SolarInvert-GmbH/inverter_assemblies--control_board/Stückliste_ST25.004_CT349066.xls

Bestück-Pos. | Menge | Artikel-Name | Artikel-Werte | Bauform | Toleranz | Hersteller | Artikel-Bezeichnung | Änd-index | Bemerkungen
Leiterplatte | 1 | Leiterplatte unbestückt | UL94-V0 120x65mm, FR4 1,55mm, 35µ Cu, Doppelseitig, Lötstopplack Top + Bottom grün, Positionsdruck top, weiß, HAL bleifrei, Ausfräsungen ca. 25mm |  |  |  | ST25.004.brd | 000
IC13 | 1 | Spannungsreferenz | 5,0V 100ppm 0,2% | SOT23-3 | 0,2 % | Fairchild | LM4040BIM3-5.0/NOPB | 003 | Farnell: 1468838
IC15 | 1 | Mikrocontroller |  | TQFP44 |  | Atmel | ATMEGA644PA-AU | 000 | Farnell: 1972106
IC12 | 1 | PMIC - Überwachungen |  | SOT23 |  | ON Semi / Catalyst | MAX809TTRG | 000 | Farnell: 1652405 Digikey: MAX809TTRGOSCT-ND
IC208 | 1 | HCF40106M013TR HCF40106BM1 | Hex Schmitt-Trigger | SOIC14 |  | ST Microelectronics ST Microelectronics | HCF40106M013TR HCF40106BM1 | 017 | Farnell: 1201301 Andere Hersteller sind gesperrt!
IC3, IC4, IC5, IC6, IC210 | 5 | CD4066BCMX HCF4066BM1 HEF4066BT | 4 Analogschalter | SOIC14 |  | Fairchild ST Microelectronics NXP | HEF4066BT | 019 | Digikey: 568-2266-1-ND Hersteller spezifiziert
IC209 | 1 | HCF4093M HEF4093 CD4093BCM HCF4093BM1 | 4 Schmitt-Trigger NAND | SOIC14 |  | ST Microelectronics NXP Fairchild ST Microelectronics | HEF4093BT | 017 | Farnell: 1201296 Hersteller spezifiziert
IC14 | 1 | RS-485 Transceiver IC | 3V to 5.5V | SOIC20W |  | Analog Devices | ADM2587EBRWZ | 000 | Digikey: ADM2587EBRWZ-REEL7TR-ND
IC201 | 1 | Operationsverstärker | 4fach | SOIC14 |  |  | LM248D | 000 | Farnell:
IC202 | 1 | Komparator | 4fach | SOIC14 |  |  | LM2901 | 000 | Digikey: 296-14593-1-ND
IC211 | 1 | D/A-Wandler |  | SOIC16 |  |  | MX7524LCSE | 000 | Digikey: MX7524LCSE+-ND
IC207 | 1 | Operationsverstärker | einfach | SO16DW |  |  | OP-200GS | 000
IC1, IC2 | 2 | I/O EXPANDER |  | TSSOP-16 |  | NXP | PCA8574PW,118 | 028 | schnellere Variante PCA... Digikey: 568-8700; Mouser No: 771-PCA85TS112 Farnell: 2212107
IC16 | 1 | Operationsverstärker | LM258 | SOIC-8 |  |  | LM258 | 027 | getestet LM258, alternative eventuell LM2904
IC17 | 1 | Optokoppler | FODM217D | SOP-4, MFP4 2.5x4.4, 1.27P |  |  | FODM217D
T201 | 1 | MOSFET | BSS123 | SOT23 | e | frei | BSS123 | 016 | Farnell: 9845321
D202, D211, D207, D203 | 4 | Doppeldiode | BAV99 | SOT23 |  | frei | BAV99LT1G | 006 | D11 --> D202 Farnell: 1431118
D205 | 1 | Doppeldiode | BAV70 | SOT23 |  | frei | BAV70 | 000 | Farnell: 1081208
D2, D10, D13, D209, D210, D213, D214, D215, D216, D217, | 10 | Diode SMD | LL1148 | SOD80C |  | frei | LL4148 | 0017 | D10,D13 hinzu Farnell: 1469399
D3, D1 | 2 | Diode | BAT46 | SOD80C |  |  | BAT46 | 020
LED1 | 1 | LED rot |  | PLCC-2 |  | Vishay | VLMS30J1L2-GS08 | 000 | Farnell: 1328348
LED2 | 1 | LED grün |  | PLCC-2 |  | Vishay | VLMC3100-GS08 | 000 | Farnell: 1659076
Q1 | 1 | Quarz | CRYSTAL 20MHZ 12PF SMD | 3,20 mm x 2,50 mm SMD |  | AKER | C3E-20.000-12-3030-X | 013 | Farnell: 1538859
T203, T204, T205, T206, T207 | 5 | 2-fach Transistor |  | SOT363-6 |  |  | MMDT5401-7-F | 017 | neu Farnell: 1773647
L1, L2 | 2 | DROSSEL | FERRITE CHIP BEAD 1k5@100MHz,300mA | 0603 oder 0805 |  | TDK |  | 005 | Digi-Key 445-2178-1-ND Farnell: 1635738
C8, C28 | 0 | SMD-Keramik-Kondensator | n.b. | 0805 | 5% | frei
C9, C10, C55, C245, C246 | 5 | SMD-Keramik-Kondensator | 12pF 5% | 0805 | 5% | frei |  | 005, 026 | Farnell: 1740650
C42, C53, C59, C216, C221, C220 | 6 | SMD-Keramik-Kondensator | 10µF/16V | 0805 | 20% | frei |  | 017 | C42 hinzu Farnell: 2320856
C2, C3, C4, C5, C26, C27, C29, C17 C18, C19, C20, C22, C23, C24, C37, C39, C41, C49, C54, C57, C58, C60, C61, C63, C64, C206, C215, C232, C234, C235, C236, C237, C238, C239, C240, C241, C242, C243, C247 | 39 | SMD-Keramik-Kondensator | 100nF/50V | 0805 | 20% | frei |  | 024 | Farnell: Entfall C42,
C7, C224, C225, C226, C227 | 5 | SMD-Keramik-Kondensator | 100pF/50V | 0805 | 20% | frei |  | 017 | Stückzahl korrigiert Farnell: 2210931
C1, C207, C244, C52, | 4 | SMD-Keramik-Kondensator | 10nF/50V | 0805 | 20% | frei |  | 020 | hinzu
C204 | 1 | SMD-Keramik-Kondensator | 4n7/50V | 0805 | 20% | frei |  | 029 | von 1nF auf 4n7:DC-Messung ruhiger
C16, C36, C205, C219, C223, | 5 | SMD-Keramik-Kondensator | 1nF/50V | 0805 | 10% | frei |  | 024 | Geändert auf 10% wegen C223 macht Takt!
C218 | 1 | SMD-Keramik-Kondensator | 1µF/25V | 0805 | 20% | frei |  | 016
 |  |  | Alle diese C´s reicht >=10V |  |  |  |  |  | Summenwert der Paare bei parallel löten
C250 | 1 | Keramikkondensator | 4n7 | 0805 | 5% | frei |  | 029 | 4n7 - 5n6 | eher oberes Fenster | Stufen bisher eher zu schwach
C250-2 | 1 | Keramikkondensator | 1nF | 0805 | 5% | frei |  | 029
C251 | 1 | Keramikkondensator | 5n6 | 0805 | 5% | frei |  | 029 | 10n - 11n
C251-2 | 1 | Keramikkondensator | 4n7 | 0805 | 5% | frei |  | 029
C252 | 1 | Keramikkondensator | 10nF | 0805 | 5% | frei |  | 029 | 20n - 22n
C252-2 | 1 | Keramikkondensator | 10nF | 0805 | 5% | frei |  | 029
C253 | 1 | Keramikkondensator | 22nF | 0805 | 5% | frei |  | 029 | 38n - 40n
C253-2 | 1 | Keramikkondensator | 18nF | 0805 | 5% | frei |  | 029
C254 | 1 | Keramikkondensator | 6n8 | 0805 | 5% | frei |  | 029 | 6n8 - 7n
C260 | 1 | Keramikkondensator | 3n3 | 0805 | 5% | frei |  | 029 | 3n9 - 4n3 | eher unteres Fenster | Steufen bisher eher zu stark
C260-2 | 1 | Keramikkondensator | 1nF | 0805 | 5% | frei |  | 029
C261 | 1 | Keramikkondensator | 4n7 | 0805 | 5% | frei |  | 029 | 8n - 8n2
C261-2 | 1 | Keramikkondensator | 3n3 | 0805 | 5% | frei |  | 029
C262 | 1 | Keramikkondensator | 8n2 | 0805 | 5% | frei |  | 029 | 15n - 16n
C262-2 | 1 | Keramikkondensator | 5n6 | 0805 | 5% | frei |  | 029
C263 | 1 | Keramikkondensator | 15nF | 0805 | 5% | frei |  | 029 | 28n - 30n
C263-2 | 1 | Keramikkondensator | 12nF | 0805 | 5% | frei |  | 029
C264 | 1 | Keramikkondensator | 6n8 | 0805 | 5% | frei |  | 029 | 6n8 - 7n
R30, R31, R32, R268 | 4 | SMD-Widerstand | 0R | 0805 | 10% | frei |  | 013
R269 | 1 | SMD-Widerstand | 120R | 0805 | 10% | frei |  | 026 | R27=n.b.
R240, R229, R233, R232, R221, R206, R205, R204,R209, R226, R223, R266, R278 | 13 | SMD-Widerstand | 100k | 0805 | 1% | frei |  | 013, 026, 029 | R266 zurück auf 100k, R209 von 47k zurück auf 100k (Overvoltage INT)
R201 | 1 | SMD-Widerstand | 100k | 0805 | 0,1% | frei |  | 013
R202 | 1 | SMD-Widerstand | 10k | 0805 | 0,1% | frei |  | 013
R203, R207, R228, R39, R239,R247, R248, R249, R253, R254, R255, R260, R277 | 13 | SMD-Widerstand | 10k | 0805 | 1% | frei |  | 019, 029 | R238, R239: 15k; R260 von 22k auf 10k Ar; R39, R239 dazu
R261 | 1 | SMD-Widerstand | 33k | 0805 | 1% | frei |  | 019 | R261 von 27k auf 33k Ar
R215, R222 | 2 | SMD-Widerstand | 68k | 0805 | 1% | frei |  | 019 | R215 von 75k auf 68k Ar
R244 | 1 | NTC | 10k NTC | 0805 |  |  |  | 015 | Farnell: 2103177
R238 | 1 | SMD-Widerstand | 15k | 0805 | 1% | frei |  | 026, 029 | R39, R239 nach 10k
R231,R208 | 2 | SMD-Widerstand | 10M | 0805 | 1% | frei |  | 000
R227 | 1 | SMD-Widerstand | 160k | 0805 | 1% | frei |  | 026, 029 | R266 zurück auf 100k,
R234, R235, R236, R237, R279 | 5 | SMD-Widerstand | 18k | 0805 | 1% | frei |  | 000, 029 | R279 hinzu von 5k6 (Overcurrent)
R22, R24, R28, R23, R246, R276 | 6 | SMD-Widerstand | 1k | 0805 | 1% | frei |  | 026
R216, R219, R243 | 3 | SMD-Widerstand | 1M | 0805 | 1% | frei |  | 019 | R218 von 2M auf 1M Ar
R218 | 1 | SMD-Widerstand | 390k | 0805 | 1% | frei |  | 021 | R218 von 1M auf 390k Ar
R29, R217 | 2 | SMD-Widerstand | 2M | 0805 | 1% | frei |  | 019 | R217 von 4M7 auf 2M Ar
R241, R242, R210 | 3 | SMD-Widerstand | 3k3 | 0805 | 1% | frei |  | 000, 029 | R220 nach 8k2
R1, R2, R3, R4, R5, R6, R7, R8, R9, R10, R11, R12, R13, R14, R15, R16, R17, R18, R19, R20, R211, R225, R230, R250 | 24 | SMD-Widerstand | 47k | 0805 | 1% | frei |  | 000, 029 | R209 nach 100k
R256, R257, R258, R259, R262, R263, | 6 | SMD-Widerstand | 4k7 | 0805 | 1% | frei |  | 017 | Farnell: 1099812, 9333274, R1...R20 neu, R220hinzu
R220,R252 | 1 | SMD-Widerstand | 8k2 | 0805 | 1% | frei |  | 013, 029 | R279 nach 18k, R252 von 5k6 auf 8k2 (Overcurrent Schwelle: einmal 5k6=8k2||18k einmal 8k2
R224, R267, R251 | 3 | SMD-Widerstand | 510k | 0805 | 1% | frei |  | 017 | 680k --> 510k
R270, R271 | 2 | SMD-Widerstand | 1k2 | 0805 | 1% | frei |  | 026, 029 | von 1k5 auf 1k2 RS485
R26, R25, R27, R33, R34, R38 | 0 | freies Pad | n.b. | 0805 |  |  |  | 026
R21, R35 | 2 | SMD-Widerstand | n.b. | 0805 | 1% | frei |  | 028, 029 | war 300k
R36, R37 | 0 | freies Pad | n.b. | 1812 |  |  |  | 028
PJ1 | 0 | Stiftleiste unbest. Abkleben | 22pol. 90°, vergoldet |  |  |  |  | 016 | Bürklin: 59F680 auf Bottom bestücken
PJ2 | 0 | Stiftleiste unbest. Abkleben | 6pol. |  |  |  |  | 016 | abkleben !!
JP1 | 1 | Stiftleiste | 2pol., RM2,54, 180° |  |  |  |  | 000 | Farnell: 3417645
JP1 | 0 | entfällt | rot, RM2,54 |  |  |  |  | 025 | Reichelt: jumper 2,54 RT Bürklin: 40 F 4236 nur innen stecken
J1 | 0 | PinSocket 2x5 1.27mm | n.b.
J3, J6 | 0 | freies THT Lötauge | n.b. | RM1,27 Pfostenstecker | 5Volt von NA Thema |  |  |  | abkleben !!
J2, J7 | 0 | freies THT Lötauge | n.b. | RM2.54Pfostenstecker | 5Volt von NA Thema |  |  | 028 | abkleben !!
J4, J5 | 2 | RJ45 Buchse | RJHSE-5380 | Raste oben |  |  | alternativ 603000-79 oder 603000-11 | 028
