SolarInvert-GmbH/inverter_assemblies--control_board/Bestückungsplan/ST25.004 Bestückungsplan BOT.pdf

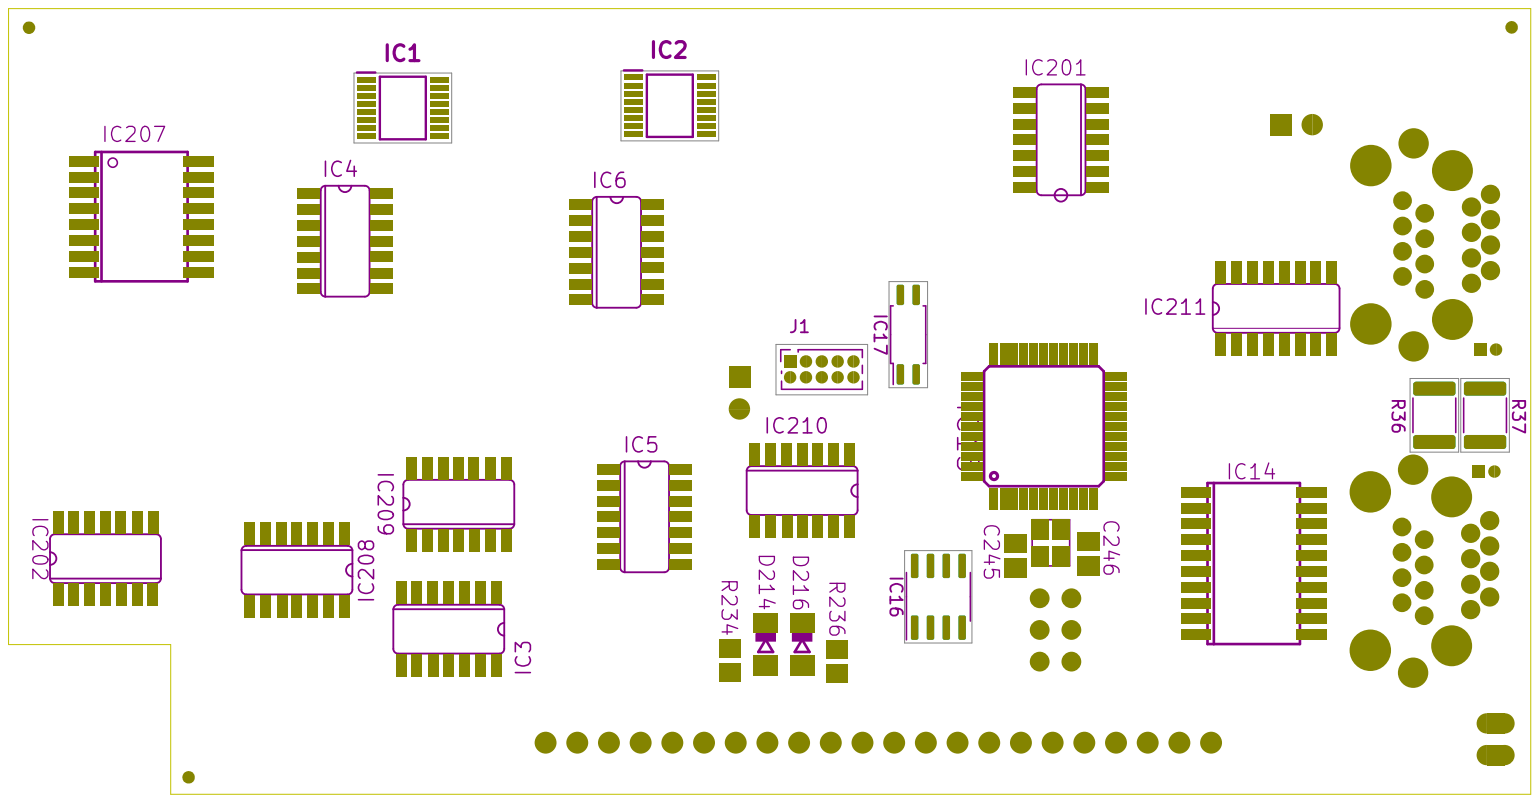
[picture p1: page 1]
