SolarInvert-GmbH/inverter_assemblies--control_board/Bestückungsplan/ST25.004 Bestückungsplan TOP.pdf

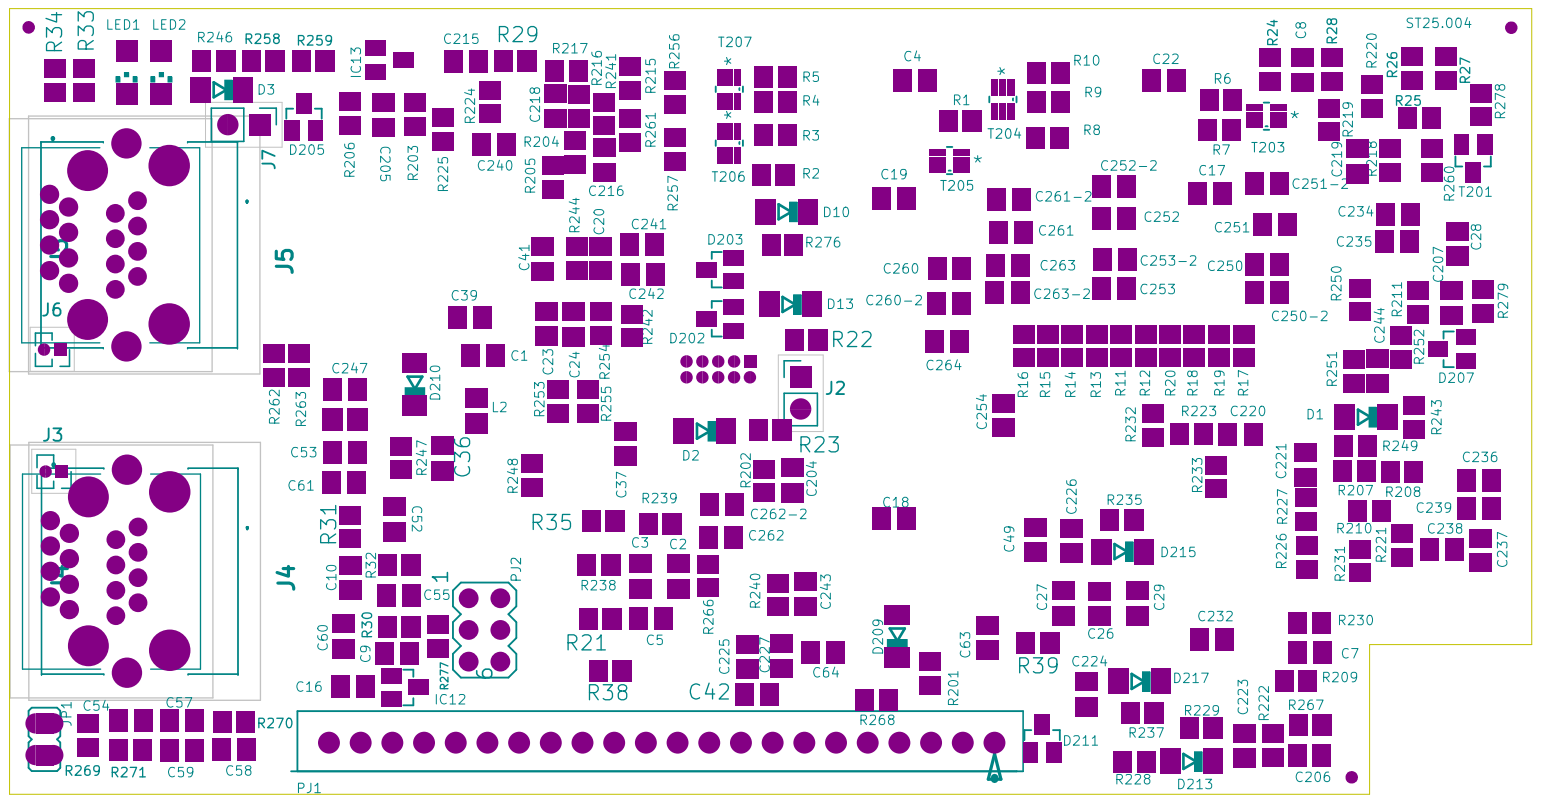
[picture p2: page 1]
