SolarInvert-GmbH/inverter_assemblies--control_board/Schaltplan/ST25.004.pdf

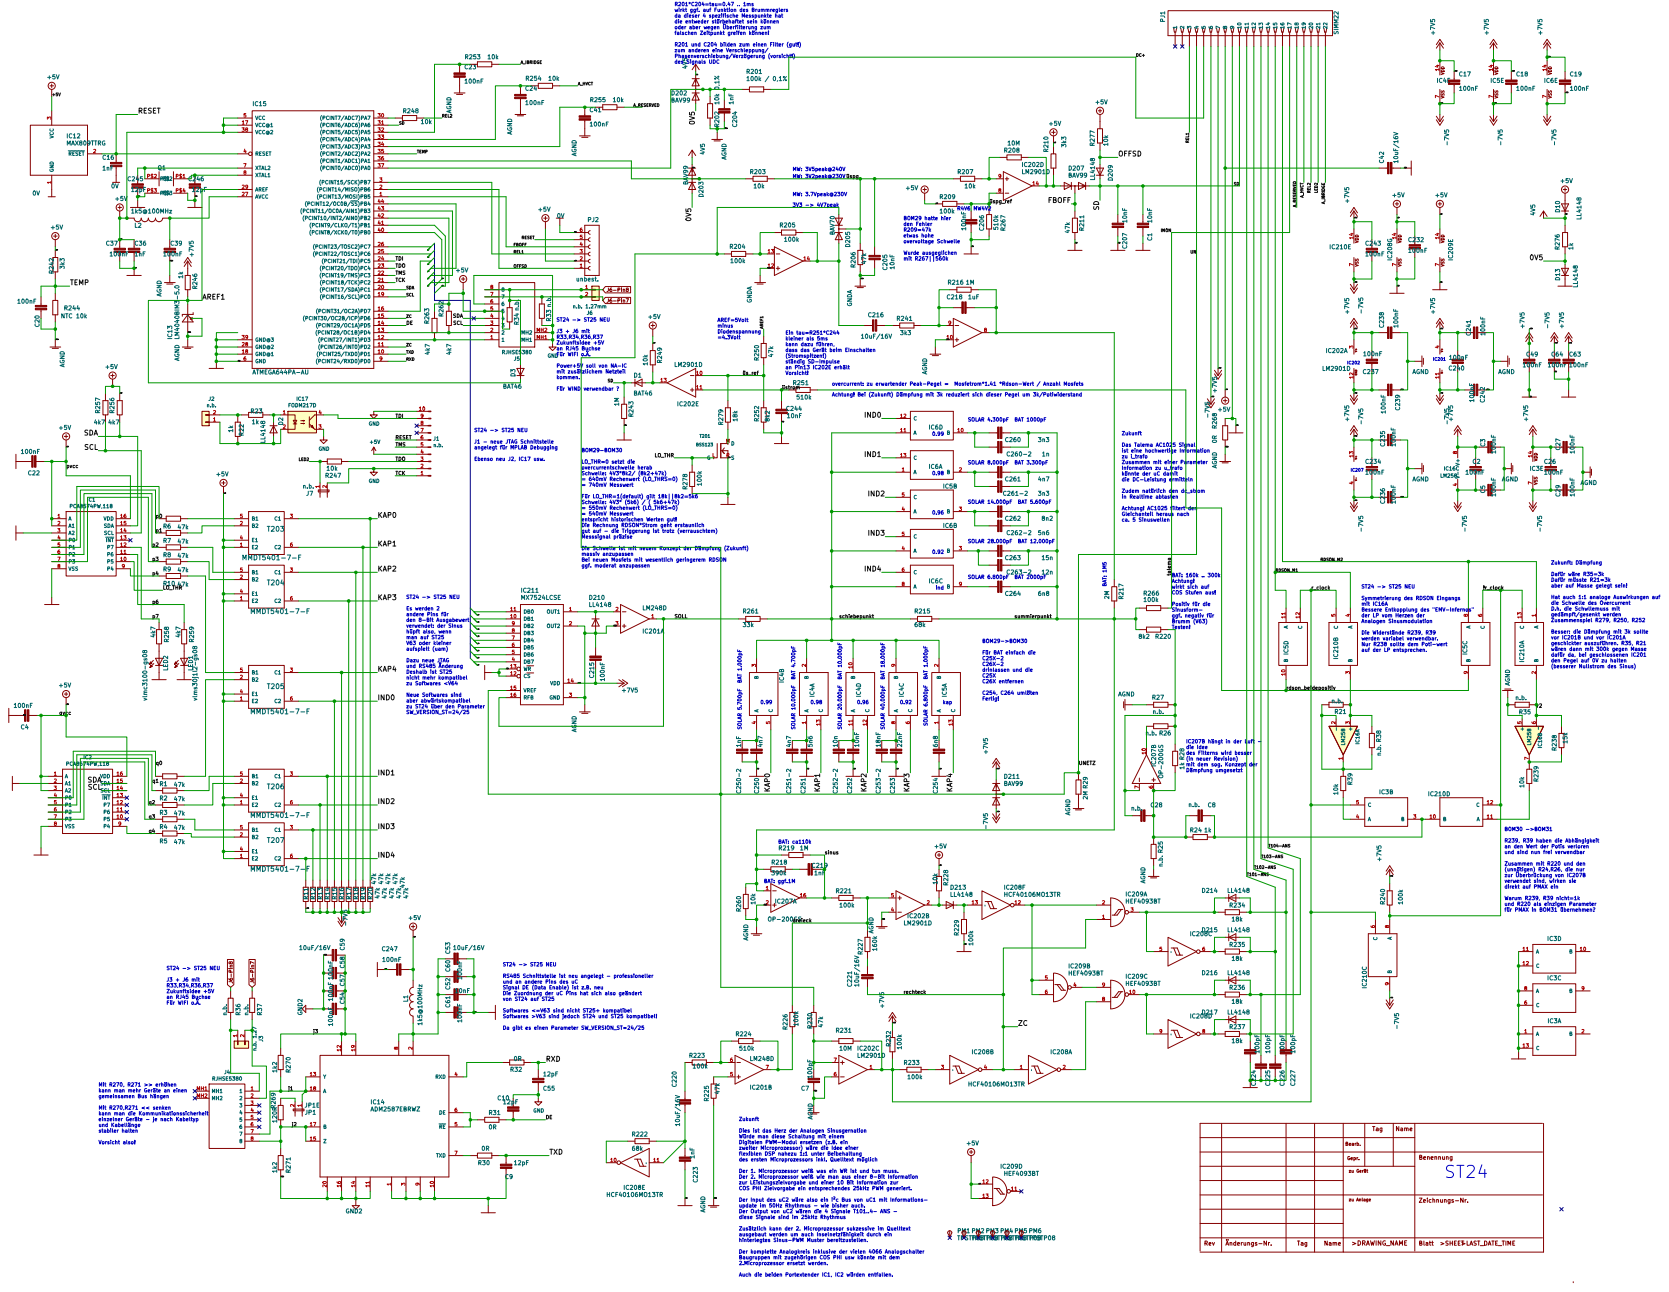
[picture p3: page 1]
