SolarInvert-GmbH/inverter_assemblies--control_board/KICAD/ST25.004.kicad_pcb

## KiCad design KICAD/ST25.004.kicad_pcb (2023-05-11)

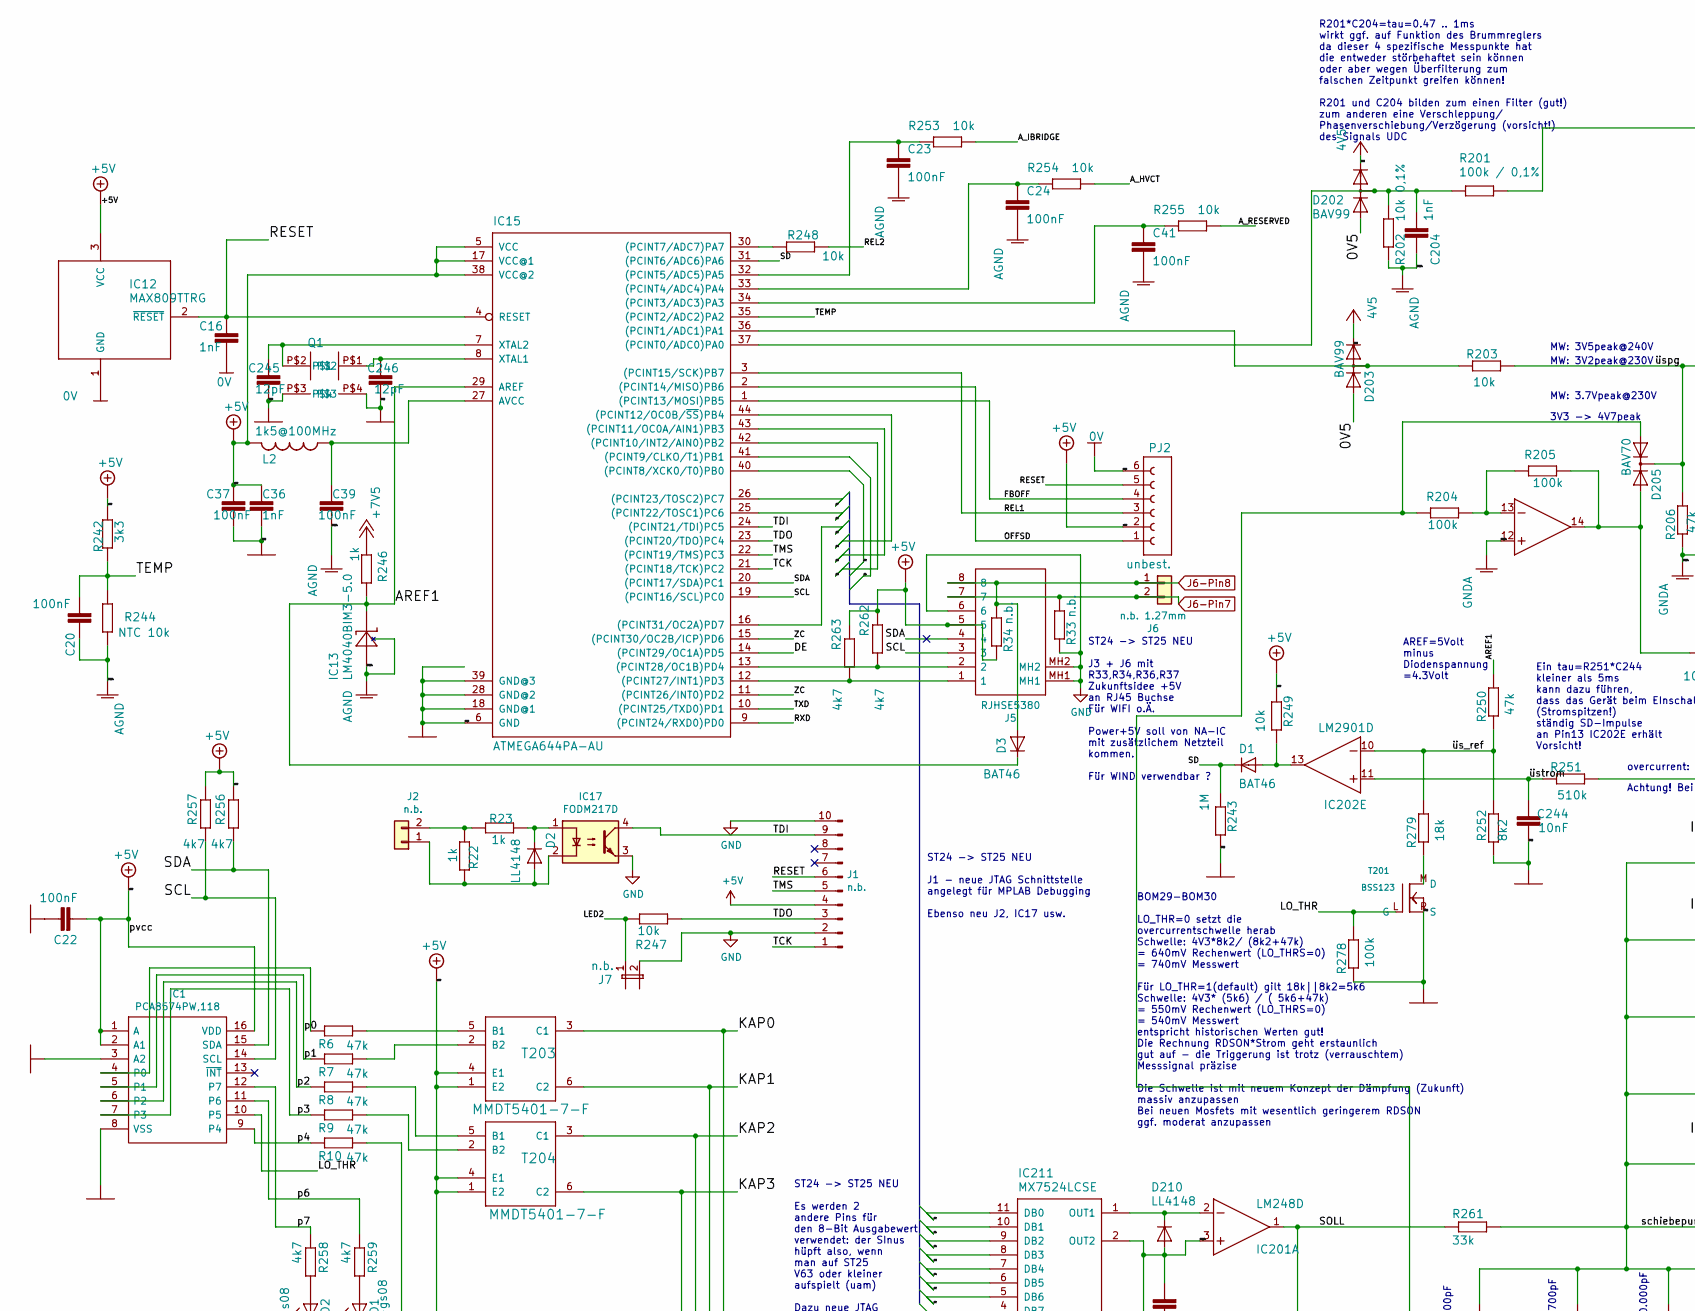
[picture p4: schematic ST25.004.sch, part in row 1, column 1]

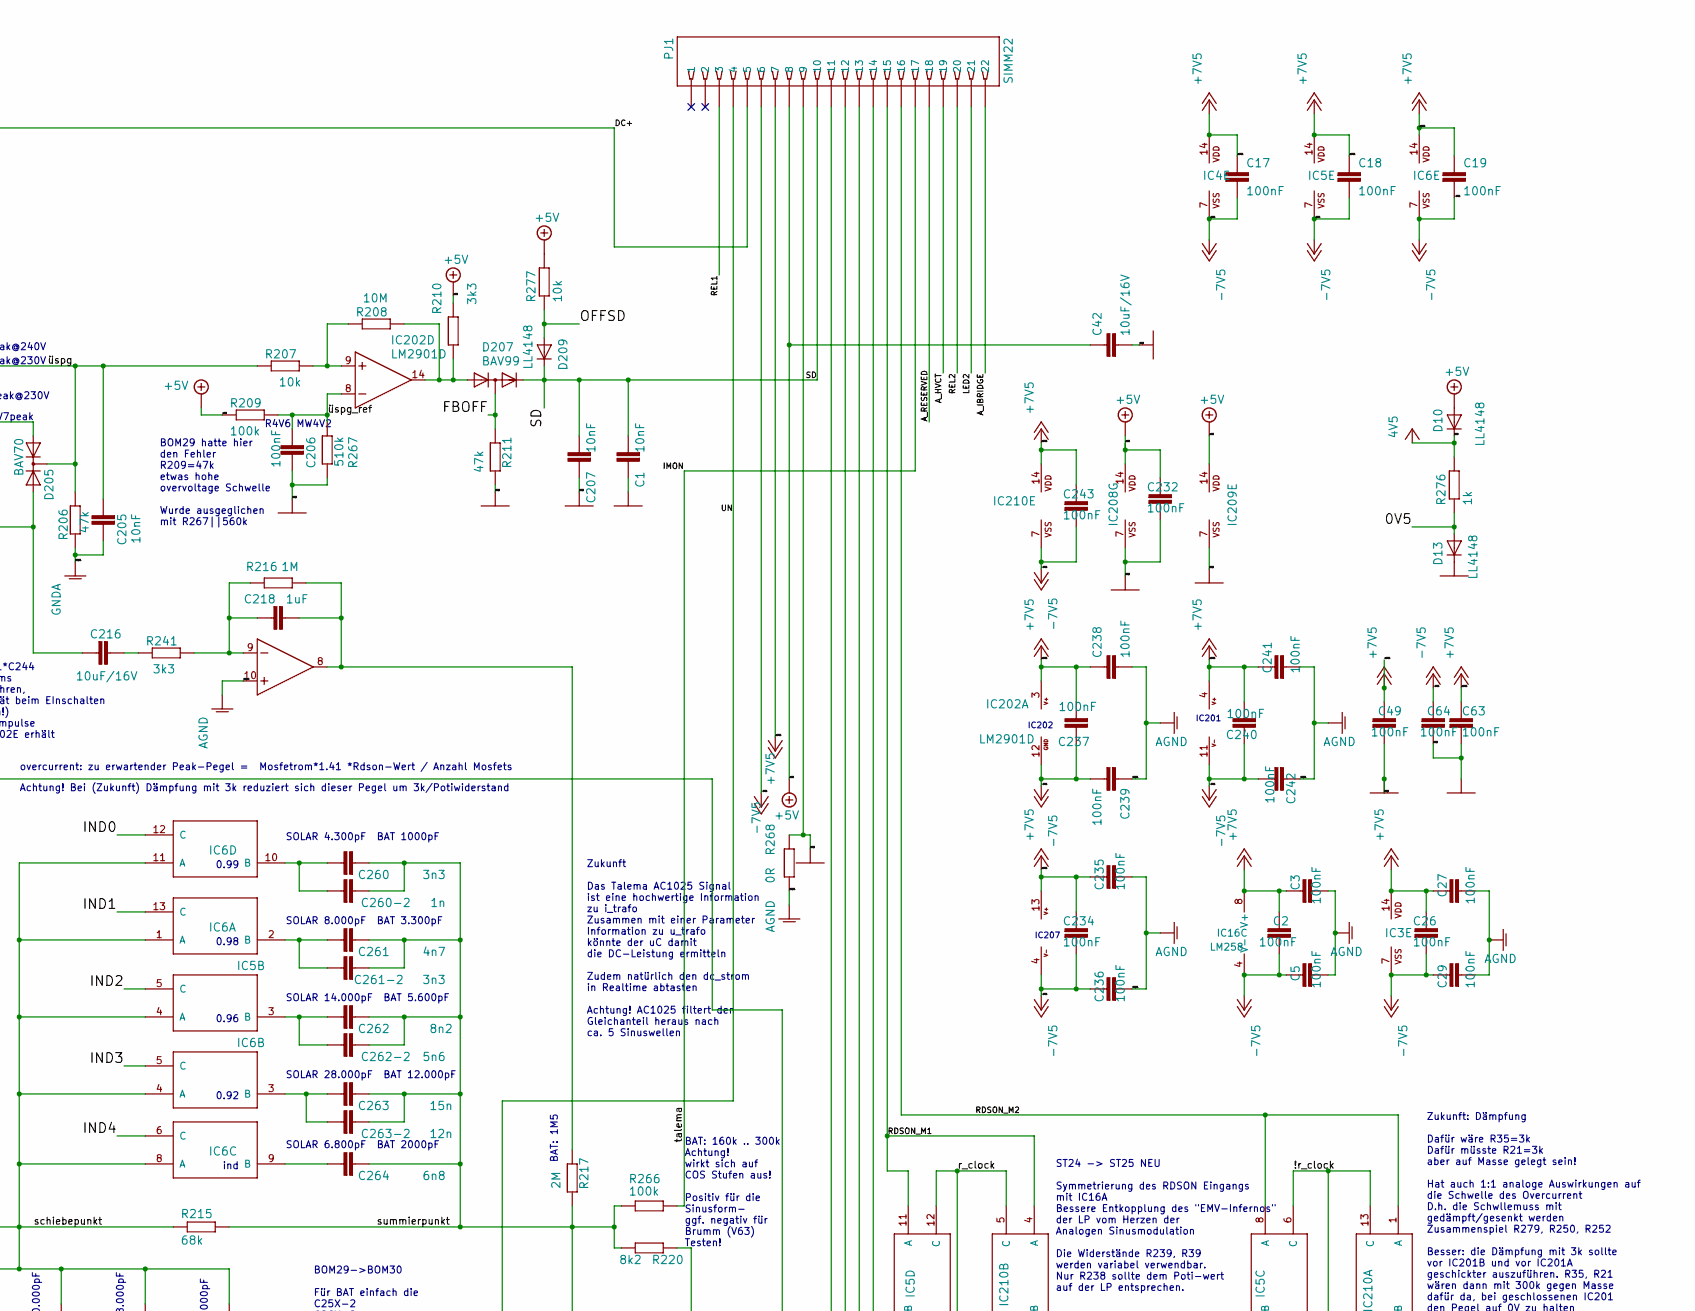
[picture p5: schematic ST25.004.sch, part in row 1, column 2]

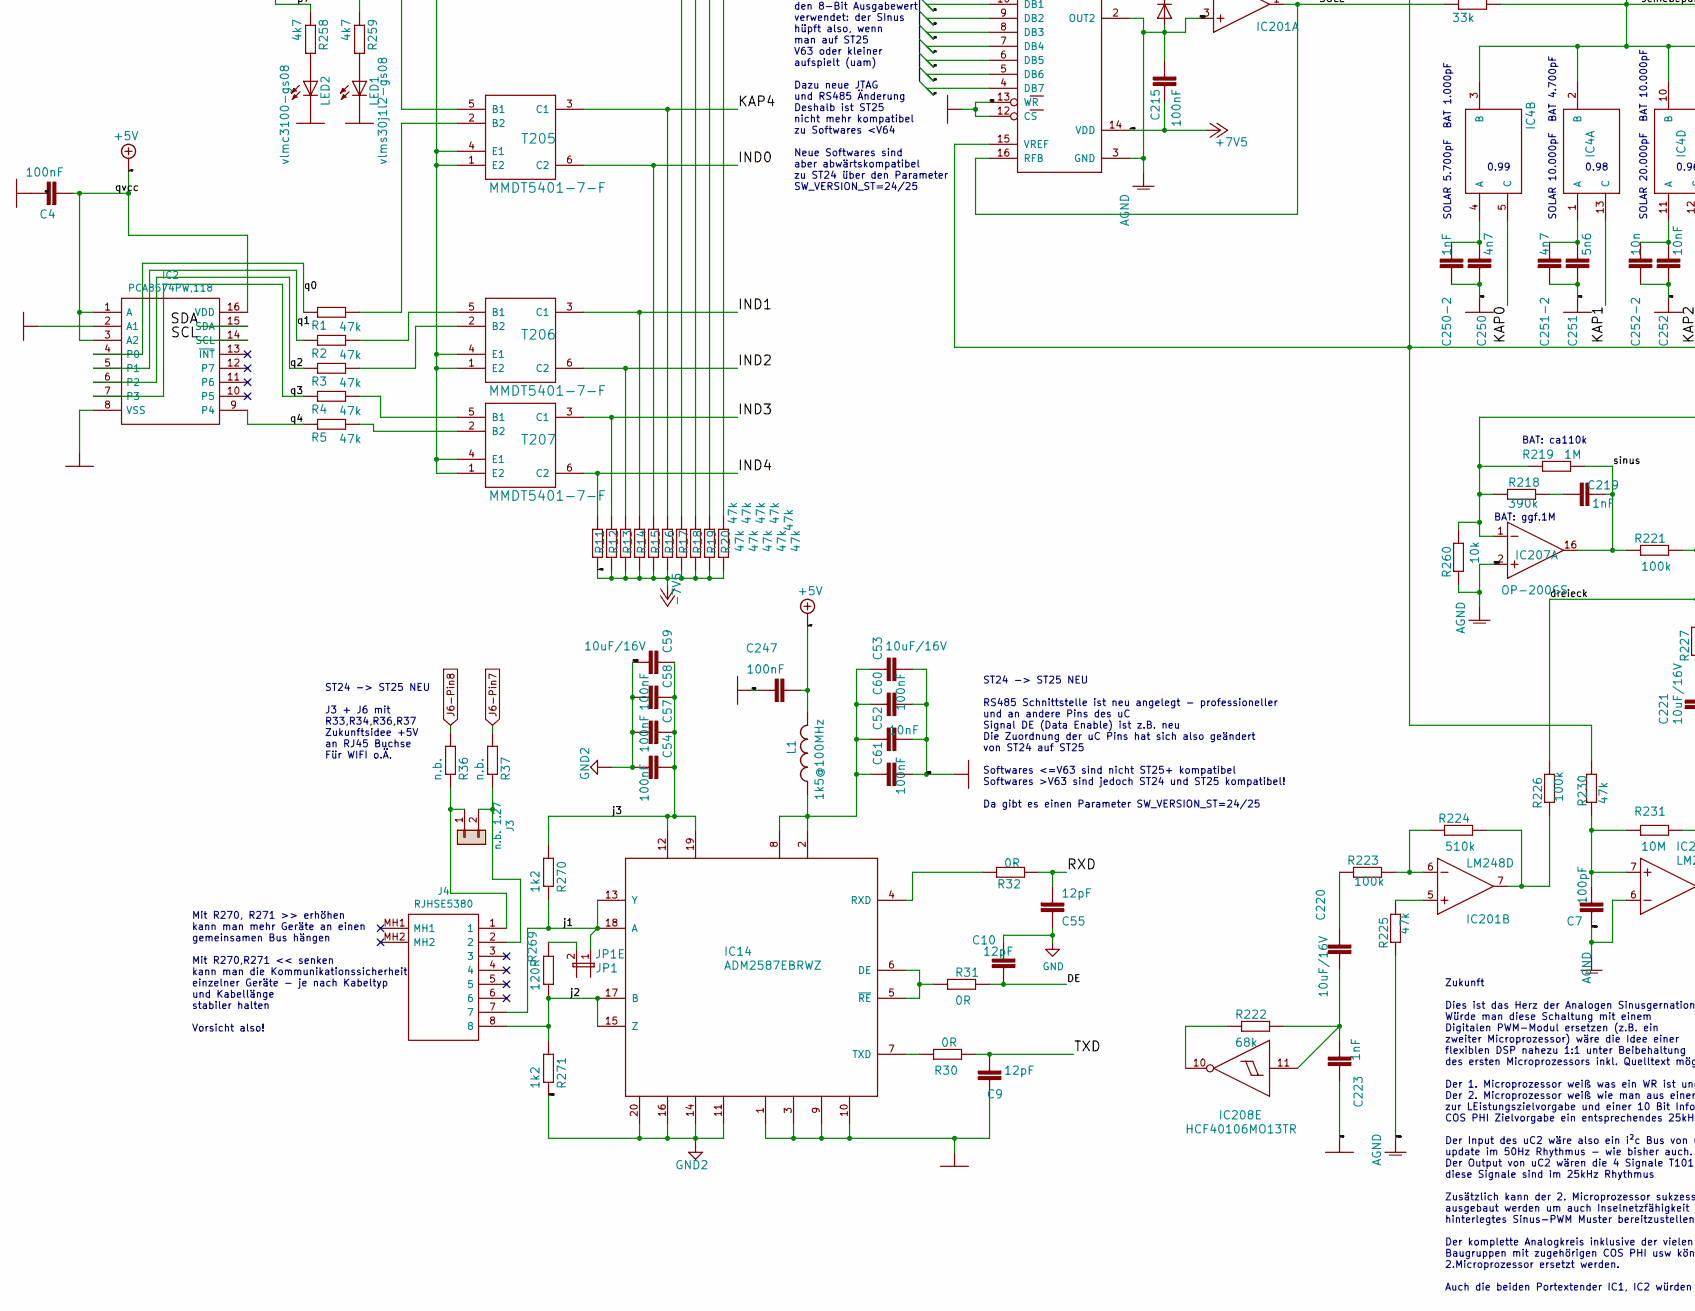
[picture p6: schematic ST25.004.sch, part in row 2, column 1]

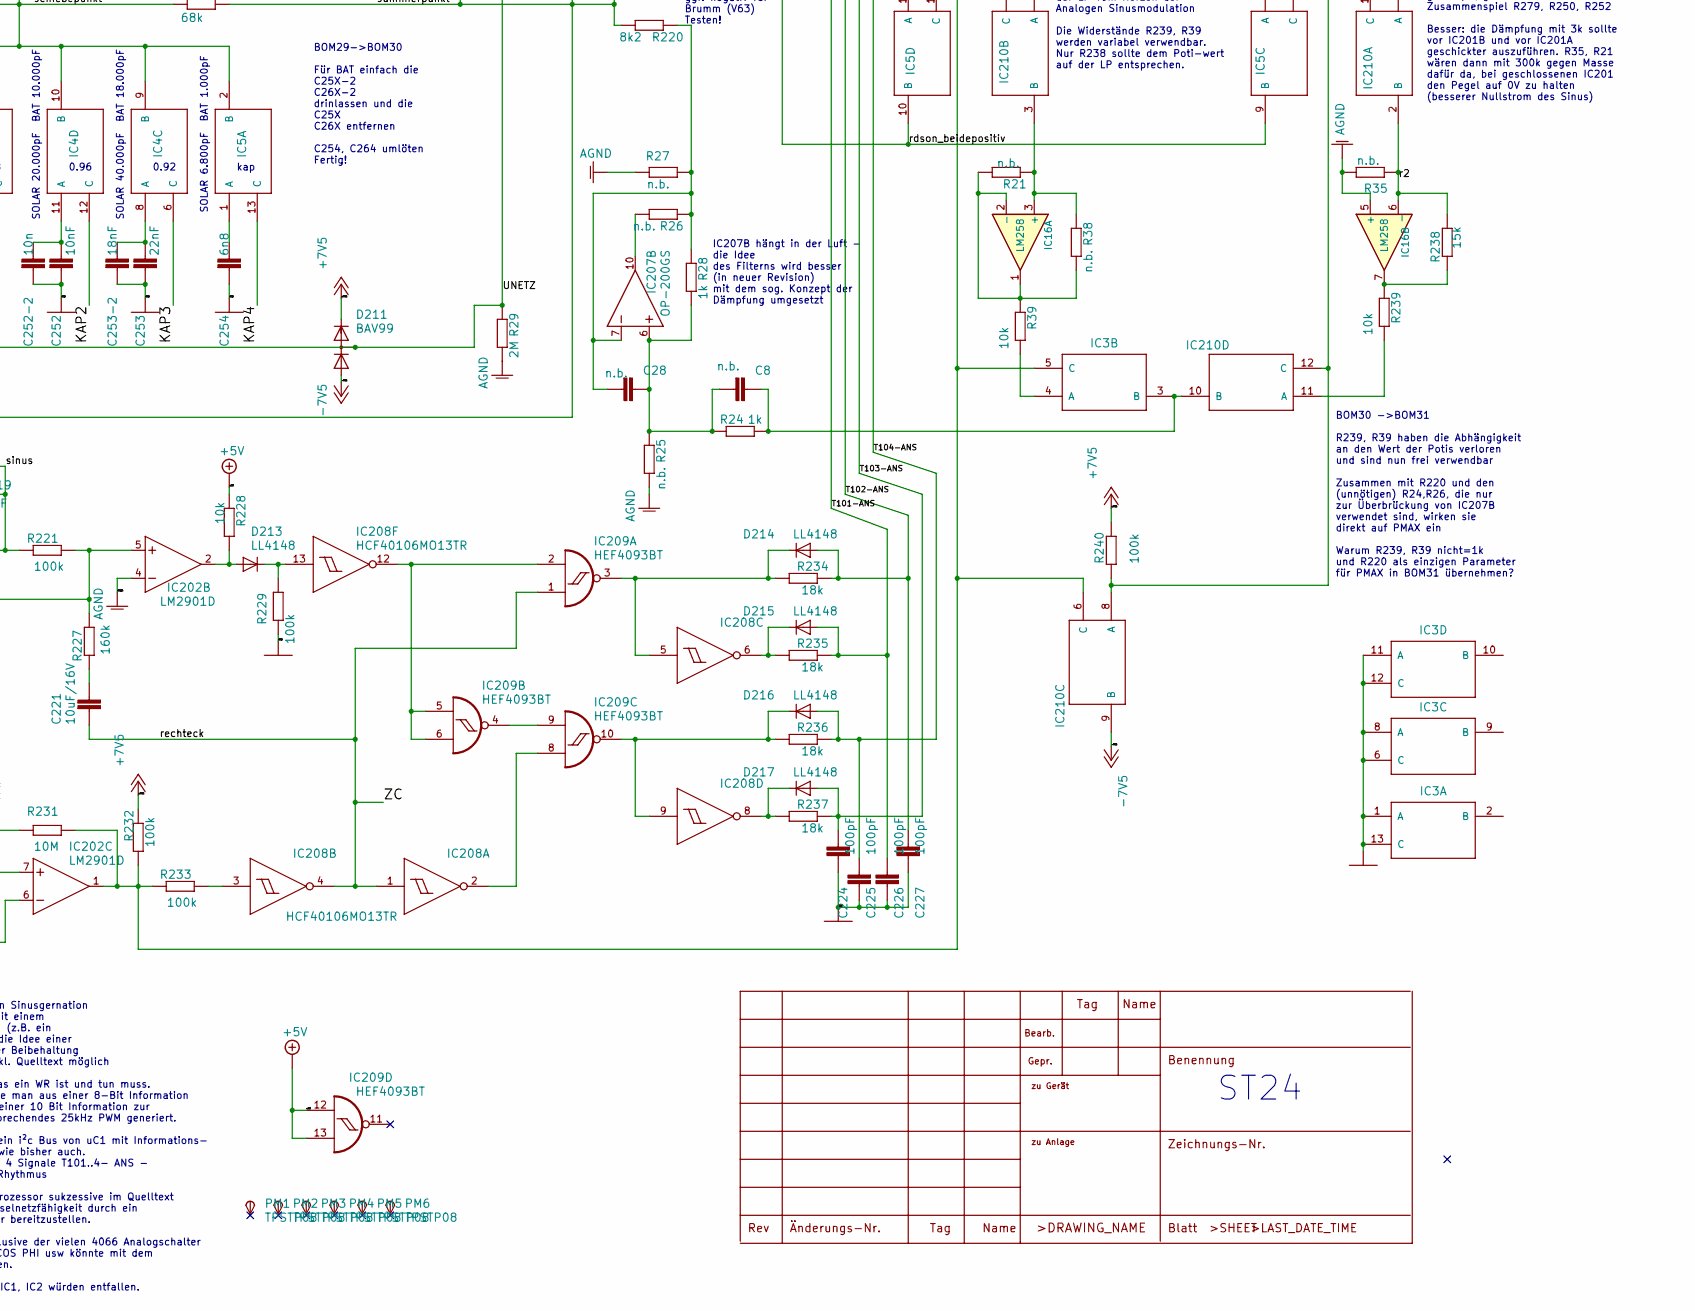
[picture p7: schematic ST25.004.sch, part in row 2, column 2]

Parts:
C1, C52, C205, C207, C244, C252: 10nF; C0805K
C2, C3, C4, C5, C17, C18, C19, C20, C22, C23, C24, C26, C27, C29, C37, C39, C41, C49, C54, C57, C58, C60, C61, C63, C64, C206, C215, C232, C234, C235, C236, C237, C238, C239, C240, C241, C242, C243, C247: 100nF; C0805K
C7, C224, C225, C226, C227: 100pF; C0805K
C8, C28: n.b.; C0805K
C9, C10, C55, C245, C246: 12pF; C0805K
C16, C36, C204, C219, C223, C250-2: 1nF; C0805K
C42, C53, C59, C216, C220, C221: 10uF/16V; C0805K
C218: 1uF; C0805K
C250, C251-2, C261: 4n7; C0805K
C251, C262-2: 5n6; C0805K
C252-2: 10n; C0805K
C253: 22nF; C0805K
C253-2: 18nF; C0805K
C254, C264: 6n8; C0805K
C260, C261-2: 3n3; C0805K
C260-2: 1n; C0805K
C262: 8n2; C0805K
C263: 15n; C0805K
C263-2: 12n; C0805K
D1, D3: BAT46; SOD80C
D2, D10, D13, D209, D210, D213, D214, D215, D216, D217: LL4148; SOD80C
D202, D203, D207, D211: BAV99; SOT23
D205: BAV70; SOT23
IC1, IC2: PCA8574PW,118; SOP65P640X110-16N; Manufacturer_Part_Number PCA8574PW,118; Mouser Part Number 771-PCA85PW118
IC3, IC4, IC5, IC6, IC210: HEF4066BT; SO14
IC12: MAX809TTRG; SOT-23
IC13: LM4040BIM3-5.0; SOT-23
IC14: ADM2587EBRWZ; SO20W
IC15: ATMEGA644PA-AU; TQFP44
IC16: LM258; SOIC-8_3.9x4.9mm_P1.27mm
IC17: FODM217D; SOP-4_4.4x2.6mm_P1.27mm
IC201: LM248D; SO14
IC202: LM2901D; SO14
IC207: OP-200GS; SO16DW
IC208: HCF40106MO13TR; SO14
IC209: HEF4093BT; SO14
IC211: MX7524LCSE; SO16
J1: n.b.; PinSocket_2x05_P1.27mm_Vertical
J2, J7: n.b.; PinHeader_1x02_P2.54mm_Vertical
J3: n.b. 1.27; PinSocket_1x02_P1.27mm_Vertical
J4, J5: RJHSE5380; RJHSE5380-SS603000-11o79merge; Mouser Part Number 523-RJLSE4038101
J6: n.b. 1.27mm; PinSocket_1x02_P1.27mm_Vertical
JP1: JP1E; JP1
L1, L2: 1k5@100MHz; 0805_0603
LED1: vlms30j1l2-gs08; CHIPLED_1206
LED2: vlmc3100-gs08; CHIPLED_1206
PJ1: SIMM22
PJ2: unbest.; CON_PJ2_AVR
PM1, PM2, PM3, PM4, PM5, PM6: TPSTP08; TP08R
Q1: C3E-20.000-12-3030-X; CRYSTALABM
R1, R2, R3, R4, R5, R6, R7, R8, R9, R10, R11, R12, R13, R14, R15, R16, R17, R18, R19, R20, R206, R211, R225, R230, R250: 47k; R0805
R21, R25, R26, R27, R33, R34, R35, R38: n.b.; R0805
R22, R23, R24, R28, R246, R276: 1k; R0805
R29, R217: 2M; R0805
R30, R31, R32, R268: 0R; R0805
R36, R37: n.b.; R_2010_5025Metric
R39, R203, R207, R228, R239, R247, R248, R249, R253, R254, R255, R260, R277: 10k; R0805
R201: 100k / 0,1%; R0805
R202: 10k 0,1%; R0805
R204, R205, R209, R221, R223, R226, R229, R232, R233, R240, R266, R278: 100k; R0805
R208, R231: 10M; R0805
R210, R241, R242: 3k3; R0805
R215, R222: 68k; R0805
R216, R219, R243: 1M; R0805
R218: 390k; R0805
R220, R252: 8k2; R0805
R224, R251, R267: 510k; R0805
R227: 160k; R0805
R234, R235, R236, R237, R279: 18k; R0805
R238: 15k; R0805
R244: NTC 10k; R0805
R256, R257, R258, R259, R262, R263: 4k7; R0805
R261: 33k; R0805
R269: 120R; R0805
R270, R271: 1k2; R0805
T201: BSS123; SOT23
T203, T204, T205, T206, T207: MMDT5401-7-F; SOT65P210X110-6N

Connections:
0V: C1.1, C4.2, C9.1, C10.2, C16.2, C22.2, C36.2, C37.2, C42.2, C49.2, C52.2, C53.2, C55.1, C60.2, C61.2, C63.2, C64.2, C206.1, C207.1, C223.1, C224.1, C225.1, C226.1, C227.1, C232.2, C244.1, C245.2, C246.2, C247.1, C250.2, C250-2.2, C251.2, C251-2.2, C252.2, C252-2.2, C253.2, C253-2.2, C254.2, D13.C, IC1.3 (A2), IC1.8 (VSS), IC2.2 (A1), IC2.8 (VSS), IC3.1 (A), IC3.6 (C), IC3.8 (A), IC3.11 (A), IC3.12 (C), IC3.13 (C), IC12.1 (GND), IC14.1, IC14.3, IC14.9, IC14.10, IC15.6 (GND), IC15.18 (GND@1), IC15.28 (GND@2), IC15.39 (GND@3), IC17.3, IC208.7 (VSS), IC209.7 (VSS), IC211.12 (CS), IC211.13 (WR), J1.2, J1.10, J5.6, J5.MH1, J5.MH2, J7.2, LED1.C, LED2.C, PJ1.9, PJ2.6, Q1.P$3, Q1.P$4, R33.2, R211.1, R229.1, R243.1, R252.2, R267.1, R268.1, R278.2, T201.R (S)
+3V3: D10.C, D202.2 (C), D203.2 (C), R276.2
+5V: C4.1, C22.1, C36.1, C37.1, C42.1, C232.1, C247.2, D10.A, IC1.1 (A), IC1.2 (A1), IC1.16 (VDD), IC2.1 (A), IC2.3 (A2), IC2.16 (VDD), IC12.3 (VCC), IC15.5 (VCC), IC15.17 (VCC@1), IC15.38 (VCC@2), IC208.14 (VDD), IC209.12 (I0), IC209.13 (I1), IC209.14 (VDD), J1.4, J5.5, L1.2, L2.2, PJ1.8, PJ2.2, R34.2, R209.2, R210.2, R228.2, R242.2, R249.2, R256.1, R257.1, R262.1, R263.1, R277.2, T203.1 (E2), T203.4 (E1), T204.1 (E2), T204.4 (E1), T205.1 (E2), T205.4 (E1), T206.1 (E2), T206.4 (E1), T207.1 (E2), T207.4 (E1)
+7V5: C2.1, C3.1, C17.1, C18.1, C19.1, C26.1, C27.1, C49.1, C63.1, C215.1, C234.1, C235.1, C237.2, C238.1, C240.2, C241.1, C243.1, D211.2 (C), IC3.14 (VDD), IC4.14 (VDD), IC5.14 (VDD), IC6.14 (VDD), IC16.8 (V+), IC201.4 (V+), IC202.3 (V+), IC207.13 (V+), IC210.14 (VDD), IC211.14 (VDD), PJ1.7, R232.2, R240.1, R246.1
-7V5: C2.2, C5.1, C17.2, C18.2, C19.2, C26.2, C29.1, C64.1, C234.2, C236.1, C237.1, C239.2, C240.1, C242.2, C243.2, D211.1 (A), IC3.7 (VSS), IC4.7 (VSS), IC5.7 (VSS), IC6.7 (VSS), IC16.4 (V-), IC201.11 (V-), IC202.12 (GND), IC207.4 (V-), IC210.7 (VSS), IC210.9 (B), PJ1.6, R11.2, R12.2, R13.2, R14.2, R15.2, R16.2, R17.2, R18.2, R19.2, R20.2
/0V5: D13.A, D202.1 (A), D203.1 (A), R276.1
/!r_clock: IC5.6 (C), IC210.8 (A), IC210.12 (C), IC210.13 (C), R240.2
/AREF1: D3.C, IC13.1 (+), IC15.29 (AREF), R246.2, R250.1
/A_HVCT: PJ1.19, R254.2
/A_IBRIDGE: PJ1.22, R253.2
/A_RESERVED: PJ1.18, R255.2
/D0: IC15.40 ((PCINT8/XCK0/T0)PB0), IC211.11 (DB0)
/D1: IC15.41 ((PCINT9/CLKO/T1)PB1), IC211.10 (DB1)
/D2: IC15.42 ((PCINT10/INT2/AIN0)PB2), IC211.9 (DB2)
/D3: IC15.43 ((PCINT11/OC0A/AIN1)PB3), IC211.8 (DB3)
/D4: IC15.44 ((PCINT12/OC0B/~SS~)PB4), IC211.7 (DB4)
/D5: IC15.16 ((PCINT31/OC2A)PD7), IC211.6 (DB5)
/D6: IC15.25 ((PCINT22/TOSC1)PC6), IC211.5 (DB6)
/D7: IC15.26 ((PCINT23/TOSC2)PC7), IC211.4 (DB7)
/DC+: PJ1.5, R201.1
/DE: C10.1, IC15.14 ((PCINT29/OC1A)PD5), R31.1
/FBOFF: D207.3 (AC), IC15.1 ((PCINT13/MOSI)PB5), PJ2.4, R211.2
/IMON: PJ1.17, R266.2
/IND0: IC6.12 (C), R15.1, T205.6 (C2)
/IND1: IC6.13 (C), R14.1, T206.3 (C1)
/IND2: IC5.5 (C), R13.1, T206.6 (C2)
/IND3: IC6.5 (C), R12.1, T207.3 (C1)
/IND4: IC6.6 (C), R11.1, T207.6 (C2)
/KAP0: IC4.5 (C), R20.1, T203.3 (C1)
/KAP1: IC4.13 (C), R19.1, T203.6 (C2)
/KAP2: IC4.12 (C), R18.1, T204.3 (C1)
/KAP3: IC4.6 (C), R17.1, T204.6 (C2)
/KAP4: IC5.13 (C), R16.1, T205.3 (C1)
/LED2: J7.1, PJ1.21, R247.1
/LO_THR: IC1.10 (P5), R278.1, T201.L (G)
/OFFSD: D209.A, IC15.2 ((PCINT14/MISO)PB6), PJ2.1, R277.1
/RDSON_M1: IC5.11 (A), IC210.4 (A), PJ1.15
/RDSON_M2: IC5.8 (A), IC210.1 (A), PJ1.16
/REL1: IC15.3 ((PCINT15/SCK)PB7), PJ1.3, PJ2.3
/REL2: PJ1.20, R248.1
/RESET: C16.1, IC12.2 (~RESET), IC15.4 (RESET), J1.6, PJ2.5
/RXD: C55.2, IC15.9 ((PCINT24/RXD0)PD0), R32.2
/SCL: IC1.14 (SCL), IC2.14 (SCL), IC15.19 ((PCINT16/SCL)PC0), J5.3, R257.2
/SD: C1.2, C207.2, D1.C, D207.2 (C), D209.C, IC15.31 ((PCINT6/ADC6)PA6), PJ1.10, R243.2
/SDA: IC1.15 (SDA), IC2.15 (SDA), IC15.20 ((PCINT17/SDA)PC1), J5.4, R256.2
/SOLL: IC201.1 (OUT), IC211.16 (RFB), R261.1
/T101-ANS: C226.2, D215.A, PJ1.11, R235.2
/T102-ANS: C227.2, D214.A, PJ1.12, R234.2
/T103-ANS: C224.2, D217.A, PJ1.13, R237.2
/T104-ANS: C225.2, D216.A, PJ1.14, R236.2
/TCK: IC15.21 ((PCINT18/TCK)PC2), J1.1
/TDI: IC15.24 ((PCINT21/TDI)PC5), IC17.4, J1.9
/TDO: IC15.23 ((PCINT20/TDO)PC4), J1.3, R247.2
/TEMP: C20.2, IC15.35 ((PCINT2/ADC2)PA2), R242.1, R244.2
/TMS: IC15.22 ((PCINT19/TMS)PC3), J1.5
/TXD: C9.2, IC15.10 ((PCINT25/TXD0)PD1), R30.1
/UN: D205.1 (A1), D211.3 (AC), IC211.15 (VREF), PJ1.4, R29.2, R204.1, R230.2
/ZC: C221.2, IC15.11 ((PCINT26/INT0)PD2), IC15.15 ((PCINT30/OC2B/ICP)PD6), IC208.1 (I), IC208.4 (O), IC209.1 (I0)
/dreieck: IC202.5 (+IN), R221.1, R226.1, R227.1
/j1: IC14.13 (Y), IC14.18 (A), J4.7, JP1.1, R270.1
/j2: IC14.15 (Z), IC14.17 (B), J4.8, R269.1, R271.2
/j3: C54.1, C57.1, C58.1, C59.1, IC14.12, IC14.19, R270.2
/p0: IC1.5 (P1), R7.1
/p2: IC1.6 (P2), R8.1
/p3: IC1.7 (P3), R9.1
/p4: IC1.9 (P4), R10.1
/p6: IC1.11 (P6), R259.1
/p7: IC1.12 (P7), R258.1
/q0: IC2.4 (P0), R1.1
/q1: IC2.5 (P1), R2.1
/q2: IC2.6 (P2), R3.1
/q3: IC2.7 (P3), R4.1
/q4: IC2.9 (P4), R5.1
/r2: IC16.6 (_), IC210.2 (B), R35.1, R238.1
/r_clock: IC3.5 (C), IC5.12 (C), IC202.1 (OUT), IC210.5 (C), IC210.6 (C), R231.2, R232.1, R233.2
/rdson_beidepositiv: IC5.9 (B), IC5.10 (B), R251.1
/schiebepunkt: IC4.2 (B), IC4.3 (B), IC4.9 (B), IC4.10 (B), IC5.2 (B), IC5.4 (A), IC6.1 (A), IC6.4 (A), IC6.8 (A), IC6.11 (A), R215.1, R261.2
/sinus: C219.2, IC207.16 (OUT), R219.1, R221.2
/summierpunkt: C260.2, C260-2.2, C261.2, C261-2.2, C262.2, C262-2.2, C263.2, C263-2.2, C264.2, IC207.1 (-IN), R215.2, R217.1, R218.2, R219.2, R220.1, R260.1, R266.1
/üs_ref: IC202.10 (-IN), R250.2, R252.1, R279.1
/üspg: C205.2, D205.3 (C), R203.1, R206.1, R207.2
/üspg_ref: C206.2, IC202.8 (-IN), R209.1, R267.2
/üstrom: C244.2, IC202.11 (+IN), R251.2
AGND: C3.2, C5.2, C7.1, C20.1, C23.2, C24.2, C27.2, C29.2, C39.2, C41.2, C204.1, C205.1, C215.2, C235.2, C236.2, C238.2, C239.1, C241.2, C242.1, D210.A, IC13.2 (-), IC13.3 (NC), IC16.5 (+), IC201.3 (+IN), IC201.10 (+IN), IC201.12 (+IN), IC202.4 (-IN), IC202.6 (-IN), IC207.2 (+IN), IC211.2 (OUT2), IC211.3 (GND), R25.1, R27.1, R29.1, R35.2, R202.1, R206.2, R225.2, R244.1, R260.2, R268.2
GND2: C54.2, C57.2, C58.2, C59.2, IC14.11, IC14.14, IC14.16, IC14.20, R271.1
J6-Pin7: J5.7, J6.2, R33.1, R37.2
J6-Pin8: D3.A, J5.8, J6.1, R34.1, R36.2
unnamed: C7.2, IC202.7 (+IN), R230.1, R231.1
unnamed: C8.1, IC3.3 (B), IC210.10 (B), R24.1
unnamed: C23.1, IC15.32 ((PCINT5/ADC5)PA5), R253.1
unnamed: C24.1, IC15.33 ((PCINT4/ADC4)PA4), R254.1
unnamed: C8.2, C28.1, IC207.6 (+IN), R24.2, R25.2, R28.1
unnamed: C28.2, IC207.7 (-IN), R26.2, R27.2, R28.2, R220.2
unnamed: C39.1, IC15.27 (AVCC), L2.1
unnamed: C41.1, IC15.34 ((PCINT3/ADC3)PA3), R255.1
unnamed: C52.1, C53.1, C60.1, C61.1, IC14.2, IC14.8, L1.1
unnamed: C204.2, D202.3 (AC), IC15.37 ((PCINT0/ADC0)PA0), R201.2, R202.2
unnamed: C216.1, R241.2
unnamed: C216.2, D205.2 (A2), IC201.14 (OUT), R205.2
unnamed: C218.1, IC201.8 (OUT), R216.2, R217.2
unnamed: C218.2, IC201.9 (-IN), R216.1, R241.1
unnamed: C219.1, R218.1
unnamed: C220.1, C223.2, IC208.11 (I), R222.1
unnamed: C220.2, R223.2
unnamed: C221.1, R227.2
unnamed: C245.1, IC15.7 (XTAL2), Q1.P$2
unnamed: C246.1, IC15.8 (XTAL1), Q1.P$1
unnamed: C250.1, C250-2.1, IC4.4 (A)
unnamed: C251.1, C251-2.1, IC4.1 (A)
unnamed: C252.1, C252-2.1, IC4.11 (A)
unnamed: C253.1, C253-2.1, IC4.8 (A)
unnamed: C254.1, IC5.1 (A)
unnamed: C260.1, C260-2.1, IC6.10 (B)
unnamed: C261.1, C261-2.1, IC6.2 (B)
unnamed: C262.1, C262-2.1, IC5.3 (B)
unnamed: C263.1, C263-2.1, IC6.3 (B)
unnamed: C264.1, IC6.9 (B)
unnamed: D1.A, IC202.13 (OUT), R249.1
unnamed: D2.A, IC17.2, J2.1, R22.2
unnamed: D2.C, IC17.1, R23.2
unnamed: D203.3 (AC), IC15.36 ((PCINT1/ADC1)PA1), R203.2
unnamed: D207.1 (A), IC202.14 (OUT), R208.1, R210.1
unnamed: D210.C, IC201.2 (-IN), IC211.1 (OUT1)
unnamed: D213.A, IC202.2 (OUT), R228.1
unnamed: D213.C, IC208.13 (I), R229.2
unnamed: D214.C, IC208.5 (I), IC209.3 (O), R234.1
unnamed: D215.C, IC208.6 (O), R235.1
unnamed: D216.C, IC208.9 (I), IC209.10 (O), R236.1
unnamed: D217.C, IC208.8 (O), R237.1
unnamed: IC1.4 (P0), R6.1
unnamed: IC3.4 (A), R39.1
unnamed: IC14.4 (RXD), R32.1
unnamed: IC14.5 (~RE), IC14.6 (DE), R31.2
unnamed: IC14.7 (TXD), R30.2
unnamed: IC15.12 ((PCINT27/INT1)PD3), J5.1, R263.2
unnamed: IC15.13 ((PCINT28/OC1B)PD4), J5.2, R262.2
unnamed: IC15.30 ((PCINT7/ADC7)PA7), R248.2
unnamed: IC16.1, IC16.2 (-), R21.1, R38.1, R39.2
unnamed: IC16.3 (+), IC210.3 (B), R21.2, R38.2
unnamed: IC16.7, R238.2, R239.2
unnamed: IC201.5 (+IN), R225.1
unnamed: IC201.6 (-IN), R223.1, R224.2
unnamed: IC201.7 (OUT), R224.1, R226.2
unnamed: IC201.13 (-IN), R204.2, R205.1
unnamed: IC202.9 (+IN), R207.1, R208.2
unnamed: IC207.10 (OUT), R26.1
unnamed: IC208.2 (O), IC209.8 (I0)
unnamed: IC208.3 (I), R233.1
unnamed: IC208.10 (O), R222.2
unnamed: IC208.12 (O), IC209.2 (I1), IC209.5 (I0), IC209.6 (I1)
unnamed: IC209.4 (O), IC209.9 (I1)
unnamed: IC210.11 (A), R239.1
unnamed: J2.2, R22.1, R23.1
unnamed: J3.1, J4.1, R36.1
unnamed: J3.2, J4.2, R37.1
unnamed: JP1.2, R269.2
unnamed: LED1.A, R259.2
unnamed: LED2.A, R258.2
unnamed: R1.2, T205.2 (B2)
unnamed: R2.2, T206.5 (B1)
unnamed: R3.2, T206.2 (B2)
unnamed: R4.2, T207.5 (B1)
unnamed: R5.2, T207.2 (B2)
unnamed: R6.2, T203.5 (B1)
unnamed: R7.2, T203.2 (B2)
unnamed: R8.2, T204.5 (B1)
unnamed: R9.2, T204.2 (B2)
unnamed: R10.2, T205.5 (B1)
unnamed: R279.2, T201.M (D)

Notes on the sheet:
IC207
IC201
IC202
ST24
SOLAR 5.700pF BAT 1.000pF
SOLAR 10.000pF BAT 4.700pF
SOLAR 20.000pF BAT 10.000pF
SOLAR 40.000pF BAT 18.000pF
SOLAR 6.800pF BAT 1.000pF
0.99
0.98
0.96
0.92
kap
ind
SOLAR 4.300pF BAT 1000pF
SOLAR 8.000pF BAT 3.300pF
SOLAR 14.000pF BAT 5.600pF
SOLAR 28.000pF BAT 12.000pF
SOLAR 6.800pF BAT 2000pF
BAT: 160k .. 300k Achtung! wirkt sich auf COS Stufen aus! Positiv für die Sinusform- ggf. negativ für Brumm (V63) Testen!
BAT: ggf.1M
BAT: ca110k
3V3 -> 4V7peak
R4V6 MW4V2
BAT: 1M5
MW: 3.7Vpeak@230V
MW: 3V2peak@230V
R201*C204=tau=0.47 .. 1ms wirkt ggf. auf Funktion des Brummreglers da dieser 4 spezifische Messpunkte hat die entweder störbehaftet sein können oder aber wegen Überfilterung zum falschen Zeitpunkt greifen können! R201 und C204 bilden zum einen Filter (gut!) zum anderen eine Verschleppung/ Phasenver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
MW: 3V5peak@240V
Mit R270, R271 >> erhöhen kann man mehr Geräte an einen gemeinsamen Bus hängen Mit R270,R271 << senken kann man die Kommunikationssicherheit einzelner Geräte - je nach Kabeltyp und Kabellänge stabiler halten Vorsicht also!
ST24 -> ST25 NEU J3 + J6 mit R33,R34,R36,R37 Zukunftsidee +5V an RJ45 Buchse Für WIFI o.Ä.
ST24 -> ST25 NEU RS485 Schnittstelle ist neu angelegt - professioneller und an andere Pins des uC Signal DE (Data Enable) ist z.B. neu Die Zuordnung der uC Pins hat sich also geändert von ST24 auf ST25 Softwares <=V63 sind nicht ST25+ kompatibel Softwares >V63 sind jedoch ST24 und ST25 kompatibel! 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
ST24 -> ST25 NEU J3 + J6 mit R33,R34,R36,R37 Zukunftsidee +5V an RJ45 Buchse Für WIFI o.Ä. Power+5V soll von NA-IC mit zusätzlichem Netzteil kommen. Für WIND verwendbar ?
ST24 -> ST25 NEU J1 - neue JTAG Schnittstelle angelegt für MPLAB Debugging Ebenso neu J2, IC17 usw.
ST24 -> ST25 NEU Symmetrierung des RDSON Eingangs mit IC16A Bessere Entkopplung des "EMV-Infernos" der LP vom Herzen der Analogen Sinusmodulation Die Widerstände R239, R39 werden variabel verwendbar. Nur R238 sollte dem Poti-wert auf der LP entsprechen.
ST24 -> ST25 NEU Es werden 2 andere Pins für den 8-Bit Ausgabewert verwendet: der SInus hüpft also, wenn man auf ST25 V63 oder kleiner aufspielt (uam) Dazu neue JTAG und RS485 Änderung Deshalb ist ST25 nicht mehr kompatibel zu Softwares <V64 Neue Softwares sind aber abwärtskompatibel zu ST24 über d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
Ein tau=R251*C244 kleiner als 5ms kann dazu führen, dass das Gerät beim EInschalten (Stromspitzen!) ständig SD-Impulse an Pin13 IC202E erhält Vorsicht!
BOM29-BOM30 LO_THR=0 setzt die overcurrentschwelle herab Schwelle: 4V3*8k2/ (8k2+47k) = 640mV Rechenwert (LO_THRS=0) = 740mV Messwert Für LO_THR=1(default) gilt 18k||8k2=5k6 Schwelle: 4V3* (5k6) / ( 5k6+47k) = 550mV Rechenwert (LO_THRS=0) = 540mV Messwert entspricht historischen Werten gut! Die Rec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
AREF=5Volt minus Diodenspannung =4.3Volt
BOM29->BOM30 Für BAT einfach die C25X-2 C26X-2 drinlassen und die C25X C26X entfernen C254, C264 umlöten Fertig!
BOM29 hatte hier den Fehler R209=47k etwas hohe overvoltage Schwelle Wurde ausgeglichen mit R267||560k
overcurrent: zu erwartender Peak-Pegel = Mosfetrom*1.41 *Rdson-Wert / Anzahl Mosfets
Achtung! Bei (Zukunft) Dämpfung mit 3k reduziert sich dieser Pegel um 3k/Potiwiderstand
Zukunft: Dämpfung Dafür wäre R35=3k Dafür müsste R21=3k aber auf Masse gelegt sein! Hat auch 1:1 analoge Auswirkungen auf die Schwelle des Overcurrent D.h. die Schwllemuss mit gedämpft/gesenkt werden Zusammenspiel R279, R250, R252 Besser: die Dämpfung mit 3k sollte vor IC201B und vor IC201A geschic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
IC207B hängt in der Luft - die Idee des Filterns wird besser (in neuer Revision) mit dem sog. Konzept der Dämpfung umgesetzt
BOM30 ->BOM31 R239, R39 haben die Abhängigkeit an den Wert der Potis verloren und sind nun frei verwendbar Zusammen mit R220 und den (unnötigen) R24,R26, die nur zur Überbrückung von IC207B verwendet sind, wirken sie direkt auf PMAX ein Warum R239, R39 nicht=1k und R220 als einzigen Parameter für P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
Zukunft Das Talema AC1025 Signal ist eine hochwertige Information zu i_trafo Zusammen mit einer Parameter Information zu u_trafo könnte der uC damit die DC-Leistung ermitteln Zudem natürlich den dc_strom in Realtime abtasten Achtung! AC1025 filtert den Gleichanteil heraus nach ca. 5 Sinuswellen
Zukunft Dies ist das Herz der Analogen Sinusgernation Würde man diese Schaltung mit einem Digitalen PWM-Modul ersetzen (z.B. ein zweiter Microprozessor) wäre die Idee einer flexiblen DSP nahezu 1:1 unter Beibehaltung des ersten Microprozessors inkl. Quelltext möglich Der 1. Microprozessor weiß was 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

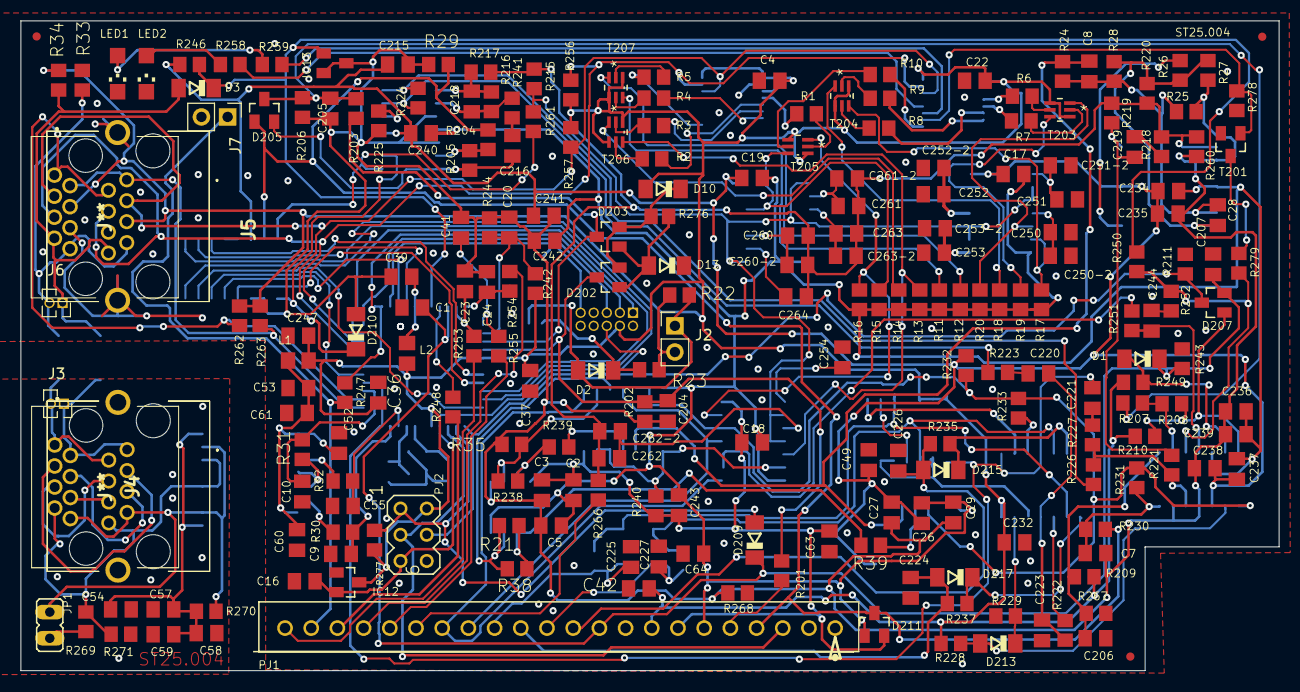
[picture p8: board ST25.004.kicad_pcb from above]

Board: 2 copper layers, 122.0 x 63.0 mm, 257 parts (0 on the bottom side), 169 nets.
